RiwB88/Termostato_AVR/csv/PID(2_0,3_8)_grafica.png

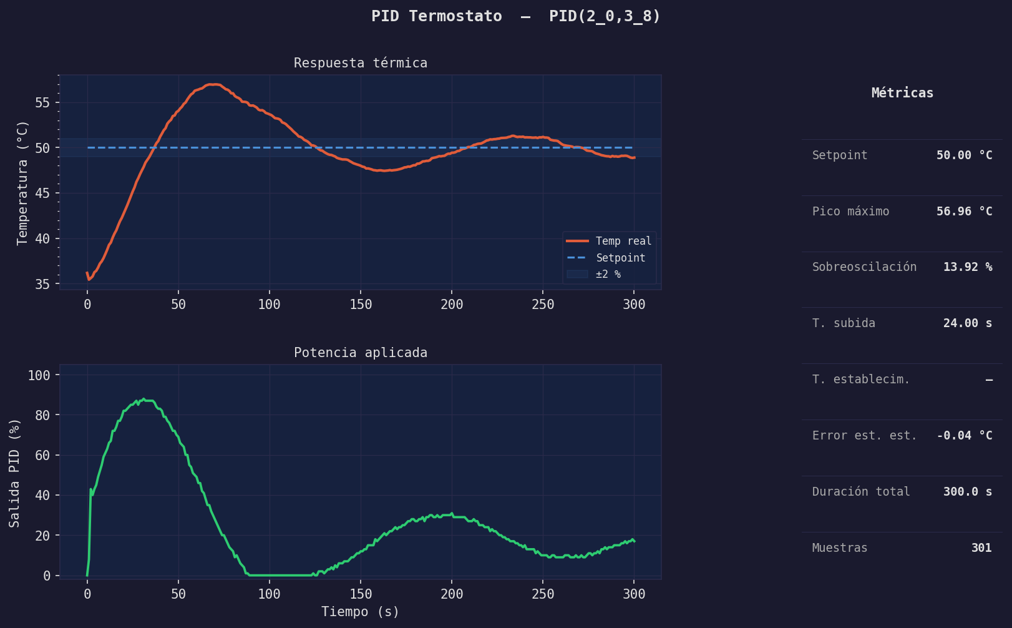
csv/PID(2_0,3_8)_grafica.png
