RiwB88/Termostato_AVR/csv/PID(2_0,3_10)_grafica.png

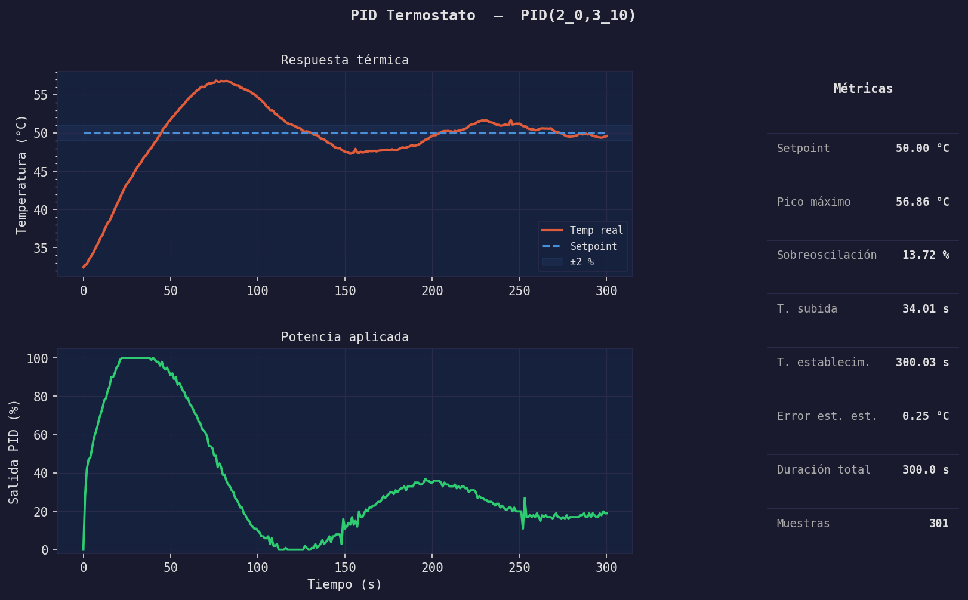
csv/PID(2_0,3_10)_grafica.png
