RiwB88/Termostato_AVR/csv/PID(2_0,15_7)_grafica.png

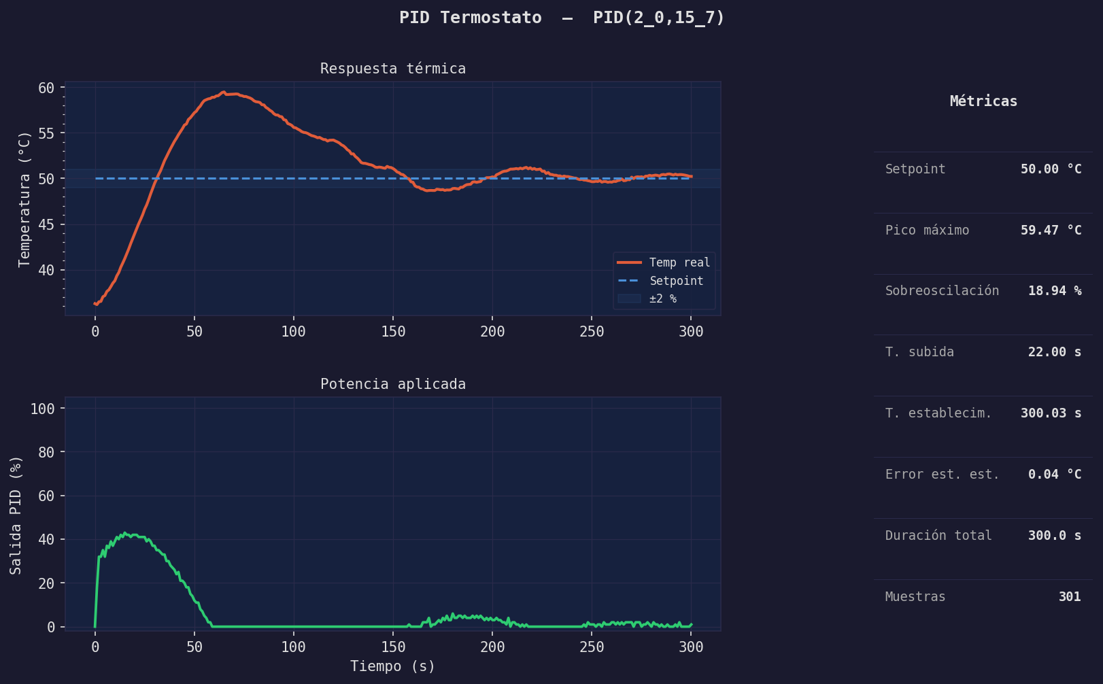
csv/PID(2_0,15_7)_grafica.png
