RiwB88/Termostato_AVR/csv/PID(2_0,28_9)_grafica.png

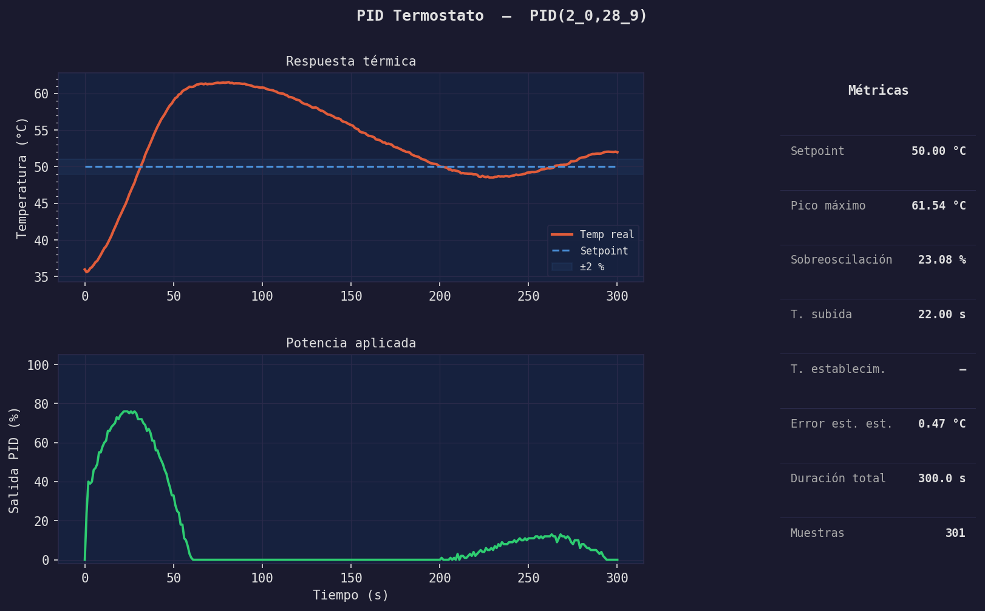
csv/PID(2_0,28_9)_grafica.png
