RiwB88/Termostato_AVR/csv/PID(2_0_0)_grafica.png

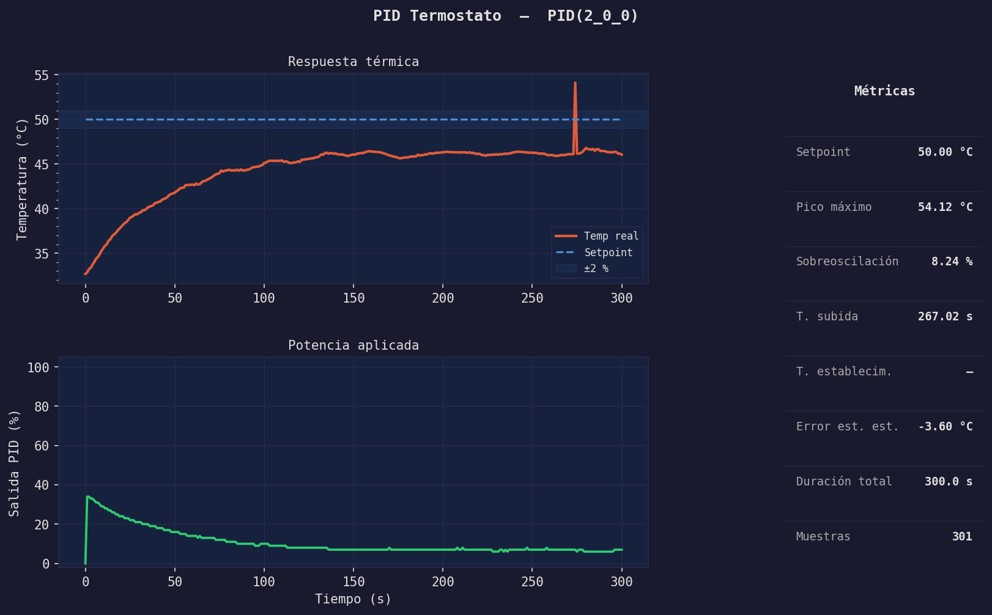
csv/PID(2_0_0)_grafica.png
