RiwB88/Termostato_AVR/(commit log)

2026-04-01 Menú y casi todas las funciones (sin PWM/PID) y no bare-metal
2026-10-24 Entega final
    [PID(2_0,15_7).csv, PID(2_0,28_9).csv, PID(2_0,3_10).csv, PID(2_0,3_8).csv, PID(2_0,5_0).csv, PID(2_0_0).csv]
